dmchristiansen/ECE411_Mini_Synth/Design Notes/Audio amplifier stage block diagram.PNG

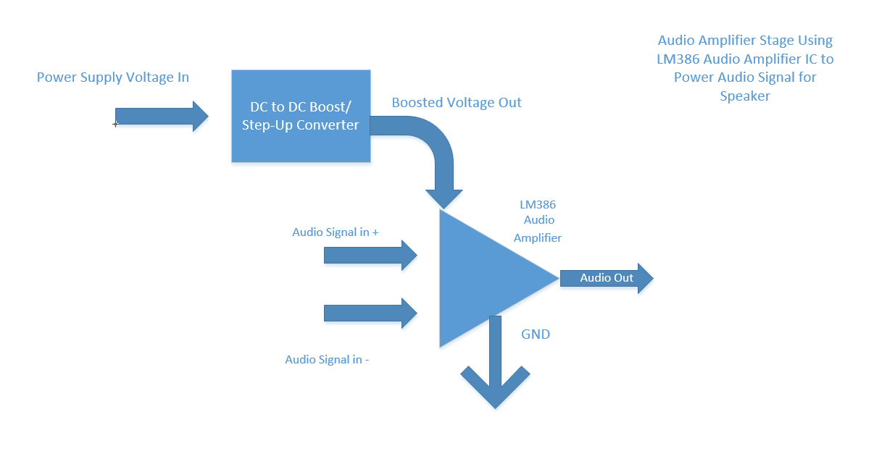
Design Notes/Audio amplifier stage block diagram.PNG
