dmchristiansen/ECE411_Mini_Synth/Design Notes/Charging Diagram.png

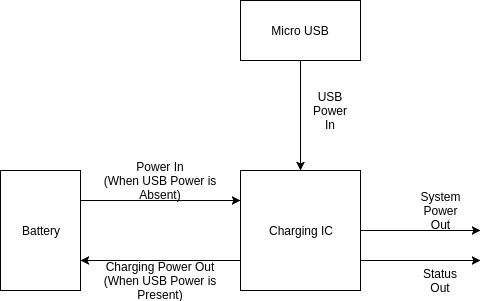
Design Notes/Charging Diagram.png
