dmchristiansen/ECE411_Mini_Synth/Design Notes/crystal_schematic.jpg

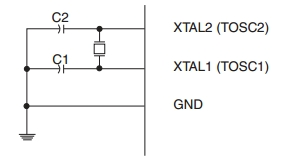
Design Notes/crystal_schematic.jpg
