dmchristiansen/ECE411_Mini_Synth/Design Notes/Top_level.png

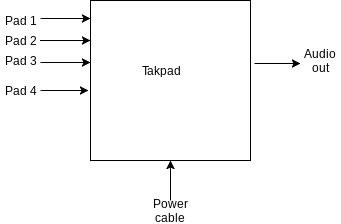
Design Notes/Top_level.png
