dmchristiansen/ECE411_Mini_Synth/Design Notes/Bill Of Materials.pdf

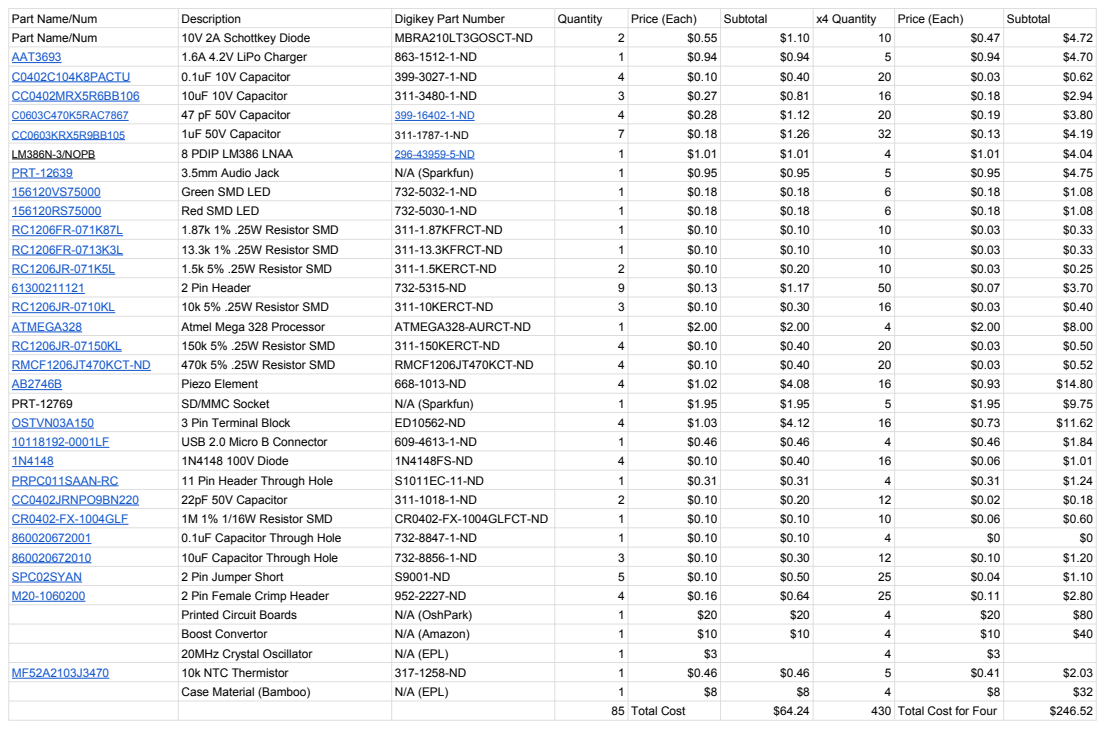
[picture p9: page 1]
Part Name/Num; Description; Digikey Part Number; Quantity; Price (Each); Subtotal; x4 Quantity; 10V 2A Schottkey Diode; MBRA210LT3GOSCT-ND; AAT3693; 1.6A 4.2V LiPo Charger; C0402C104K8PACTU; 0.1uF 10V Capacitor; CC0402MRX5R6BB106; 10uF 10V Capacitor; C0603C470K5RAC7867; 47 pF 50V Capacitor; CC0603KRX5R9BB105; 1uF 50V Capacitor; LM386N-3/NOPB; 8 PDIP LM386 LNAA; PRT-12639; 3.5mm Audio Jack; N/A (Sparkfun); Green SMD LED; Red SMD LED; 1.87k 1% .25W Resistor SMD; 311-1.87KFRCT-ND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
