dmchristiansen/ECE411_Mini_Synth/Board Design/takpad6.2.brd

## EAGLE design Board Design/takpad6.2.brd (2017-11-16)

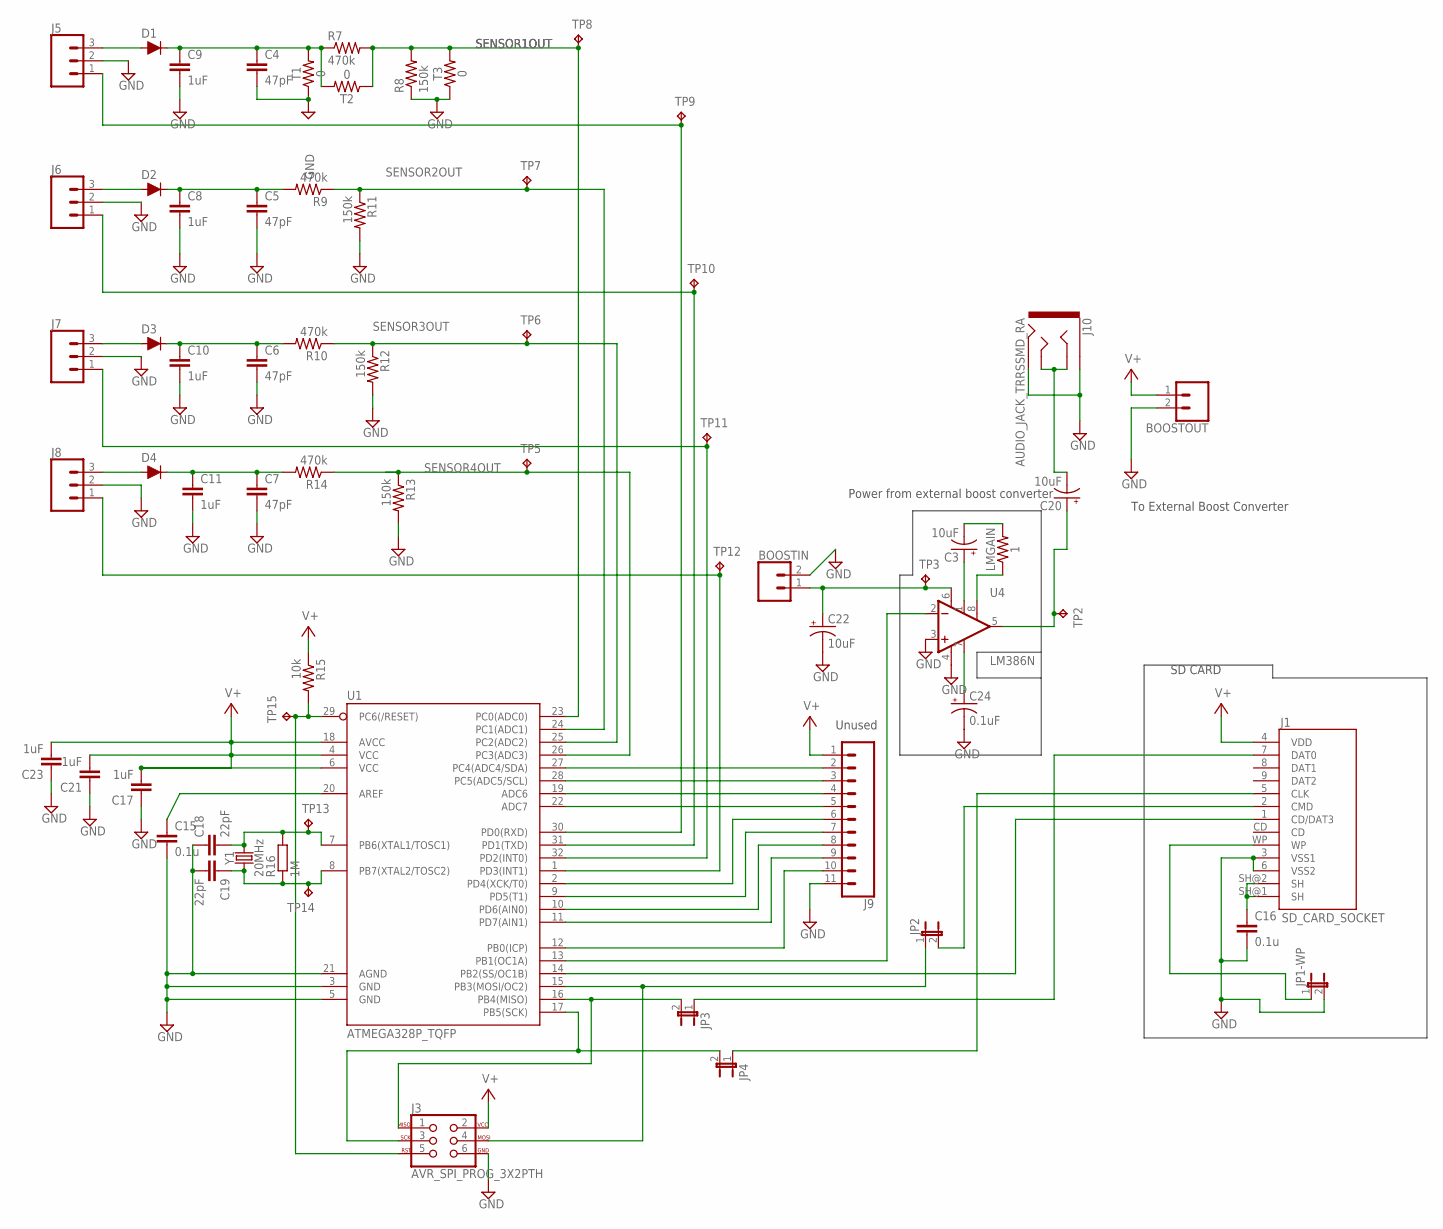
[picture p10: schematic takpad6.2.sch, sheet 1]

Parts:
BOOSTIN: CONN_02; 1X02
BOOSTOUT: CONN_02; 1X02
C3, C20, C22: 10uF; CPOL-RADIAL-2.5MM-5MM-KIT
C4, C5, C6, C7: 47pF; 0603
C8, C9, C10, C11, C17, C21, C23: 1uF; 0603
C15, C16: 0.1u; C0402
C18, C19: 22pF; C0402
C24: 0.1uF; CPOL-RADIAL-2.5MM-5MM-KIT
D1, D2, D3, D4: 200mA/100V/1V; DIODE-1N4148
J1: SD_CARD_SOCKET; SD
J3: AVR_SPI_PROG_3X2PTH; 2X3
J5, J6, J7, J8: CONN_03; 1X03
J9: CONN_11; 1X11
J10: AUDIO_JACK_TRRSSMD_RA; AUDIO_JACK_3.5MM_TRRS_SMD_RA
JP1-WP, JP2, JP3, JP4: JUMPER-2PTH; 1X02
LMGAIN: 1; 0603
R7, R9, R10, R14: 470k; M1206
R8, R11, R12, R13: 150k; M1206
R15: 10k; M1206
R16: 1M; R0402
T1, T2, T3: 0; AXIAL-0.3
TP2, TP3, TP5, TP6, TP7, TP8, TP9, TP10, TP11, TP12, TP13, TP14, TP15: TPB1,27; B1,27
U1: ATMEGA328P_TQFP; TQFP32-08
U4: LM386N; DIP08
Y1: 20MHz; HC49US

Connections:
ADC4: J9.2, U1.27 (PC4(ADC4/SDA))
ADC5: J9.3, U1.28 (PC5(ADC5/SCL))
ADC6: J9.4, U1.19 (ADC6)
ADC7: J9.5, U1.22 (ADC7)
AREF: C15.1, U1.20 (AREF)
AUDIOINPUT: U1.13 (PB1(OC1A)), U4.2 (-IN)
AUDIOOUT: C20.1 (+), TP2.TP, U4.5 (OUT)
BYPASS: C24.1 (+), U4.7 (BP)
CD/DAT3: J1.1 (CD/DAT3), U1.14 (PB2(SS/OC1B))
CLK: J1.5 (CLK), JP4.1
CMD: J1.2 (CMD), JP2.2
DAT0: J1.7 (DAT0), JP3.1
GND: BOOSTIN.2, BOOSTOUT.2, C4.2, C5.2, C6.2, C7.2, C8.2, C9.2, C10.2, C11.2, C15.2, C16.2, C17.1, C18.1, C19.2, C21.1, C22.2 (-), C23.1, C24.2 (-), J1.3 (VSS1), J1.6 (VSS2), J3.6, J5.2, J6.2, J7.2, J8.2, J9.11, J10.EARTH, J10.RING2, JP1-WP.2, R8.1, R11.2, R12.2, R13.2, T1.P$1 (1), T3.P$1 (1), U1.3 (GND), U1.5 (GND), U1.21 (AGND), U4.3 (+IN), U4.4 (V-); also elsewhere on the board
MISO: J3.1, JP3.2, U1.16 (PB4(MISO))
MOSI: J3.4, JP2.1, U1.15 (PB3(MOSI/OC2))
unnamed: C20.2 (-), J10.RING1, J10.TIP
unnamed: C3.1 (+), U4.1 (GAIN)
unnamed: C3.2 (-), LMGAIN.2
unnamed: LMGAIN.1, U4.8 (GAIN)
unnamed: C16.1, J1.SH@1 (SH), J1.SH@2 (SH)
PB6: C18.2, R16.2, TP13.TP, U1.7 (PB6(XTAL1/TOSC1)), Y1.2
PB7: C19.1, R16.1, TP14.TP, U1.8 (PB7(XTAL2/TOSC2)), Y1.1
PD4: J9.6, U1.2 (PD4(XCK/T0))
PD5: J9.7, U1.9 (PD5(T1))
PD6: J9.8, U1.10 (PD6(AIN0))
PD7: J9.9, U1.11 (PD7(AIN1))
PD8: J9.10, U1.12 (PB0(ICP))
RST: J3.5, R15.2, TP15.TP, U1.29 (PC6(/RESET))
SCK: J3.3, JP4.2, U1.17 (PB5(SCK))
SENS1LED: J5.1, TP9.TP, U1.30 (PD0(RXD))
SENS2LED: J6.1, TP10.TP, U1.31 (PD1(TXD))
SENS3LED: J7.1, TP11.TP, U1.32 (PD2(INT0))
SENS4LED: J8.1, TP12.TP, U1.1 (PD3(INT1))
SENSOR1: D1.A, J5.3
SENSOR1IN: C4.1, C9.1, D1.C, R7.1, T1.P$2 (2), T2.P$2 (2)
SENSOR1OUT: R7.2, R8.2, T2.P$1 (1), T3.P$2 (2), TP8.TP, U1.23 (PC0(ADC0))
SENSOR2: D2.A, J6.3
SENSOR2IN: C5.1, C8.1, D2.C, R9.2
SENSOR2OUT: R9.1, R11.1, TP7.TP, U1.24 (PC1(ADC1))
SENSOR3: D3.A, J7.3
SENSOR3IN: C6.1, C10.1, D3.C, R10.2
SENSOR3OUT: R10.1, R12.1, TP6.TP, U1.25 (PC2(ADC2))
SENSOR4: D4.A, J8.3
SENSOR4IN: C7.1, C11.1, D4.C, R14.2
SENSOR4OUT: R13.1, R14.1, TP5.TP, U1.26 (PC3(ADC3))
UPCONVERTERINPUT: BOOSTIN.1, C22.1 (+), TP3.TP, U4.6 (V+)
V+: BOOSTOUT.1, C17.2, C21.2, C23.2, J1.4 (VDD), J3.2, J9.1, R15.1, U1.4 (VCC), U1.6 (VCC), U1.18 (AVCC); also elsewhere on the board
WP: J1.WP, JP1-WP.1

Notes on the sheet:
SD CARD
To External Boost Converter
Power from external boost converter
Unused

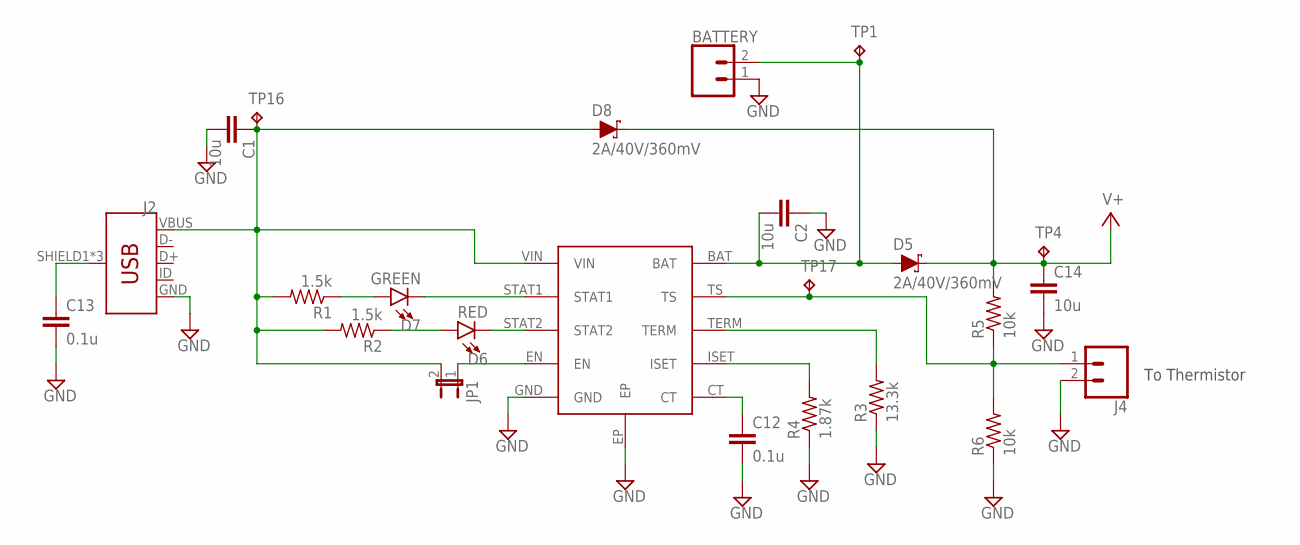
[picture p11: schematic takpad6.2.sch, sheet 2]

Parts:
BATTERY: CONN_02; 1X02
C1, C2, C14: 10u; C0402
C12, C13: 0.1u; C0402
D5, D8: 2A/40V/360mV; SMA-DIODE
D6: RED; LED-1206
D7: GREEN; LED-1206
J2: USB_MICRO-BREDUCED_PASTE; USB-B-MICRO-SMD_RED_PASTE
J4: CONN_02; 1X02
JP1: JUMPER-2PTH; 1X02
R1, R2: 1.5k; M1206
R3: 13.3k; M1206
R4: 1.87k; M1206
R5, R6: 10k; M1206
TP1, TP4, TP16, TP17: TPB1,27; B1,27
U$1: AAT3693; IDH-AA-T1

Connections:
BAT: BATTERY.2, C2.2, D5.A, TP1.TP, U$1.BAT
CT: C12.1, U$1.CT
EN: JP1.1, U$1.EN
GND: BATTERY.1, C1.2, C2.1, C12.2, C13.2, C14.2, J2.GND, J4.2, R3.1, R4.1, R6.1, U$1.EP, U$1.GND; also elsewhere on the board
ISET: R4.2, U$1.ISET
unnamed: C13.1, J2.SHIELD1 (SHIELD), J2.SHIELD2 (SHIELD), J2.SHIELD3 (SHIELD)
STAT1: D7.C, U$1.STAT1
STAT1LED: D7.A, R1.1
STAT2: D6.C, U$1.STAT2
STAT2LED: D6.A, R2.1
TEMPSENSE: J4.1, R5.1, R6.2, TP17.TP, U$1.TS
TERM: R3.2, U$1.TERM
V+: C14.1, D5.C, D8.C, R5.2, TP4.TP; also elsewhere on the board
VIN: C1.1, D8.A, J2.VBUS, JP1.2, R1.2, R2.2, TP16.TP, U$1.VIN

Notes on the sheet:
To Thermistor

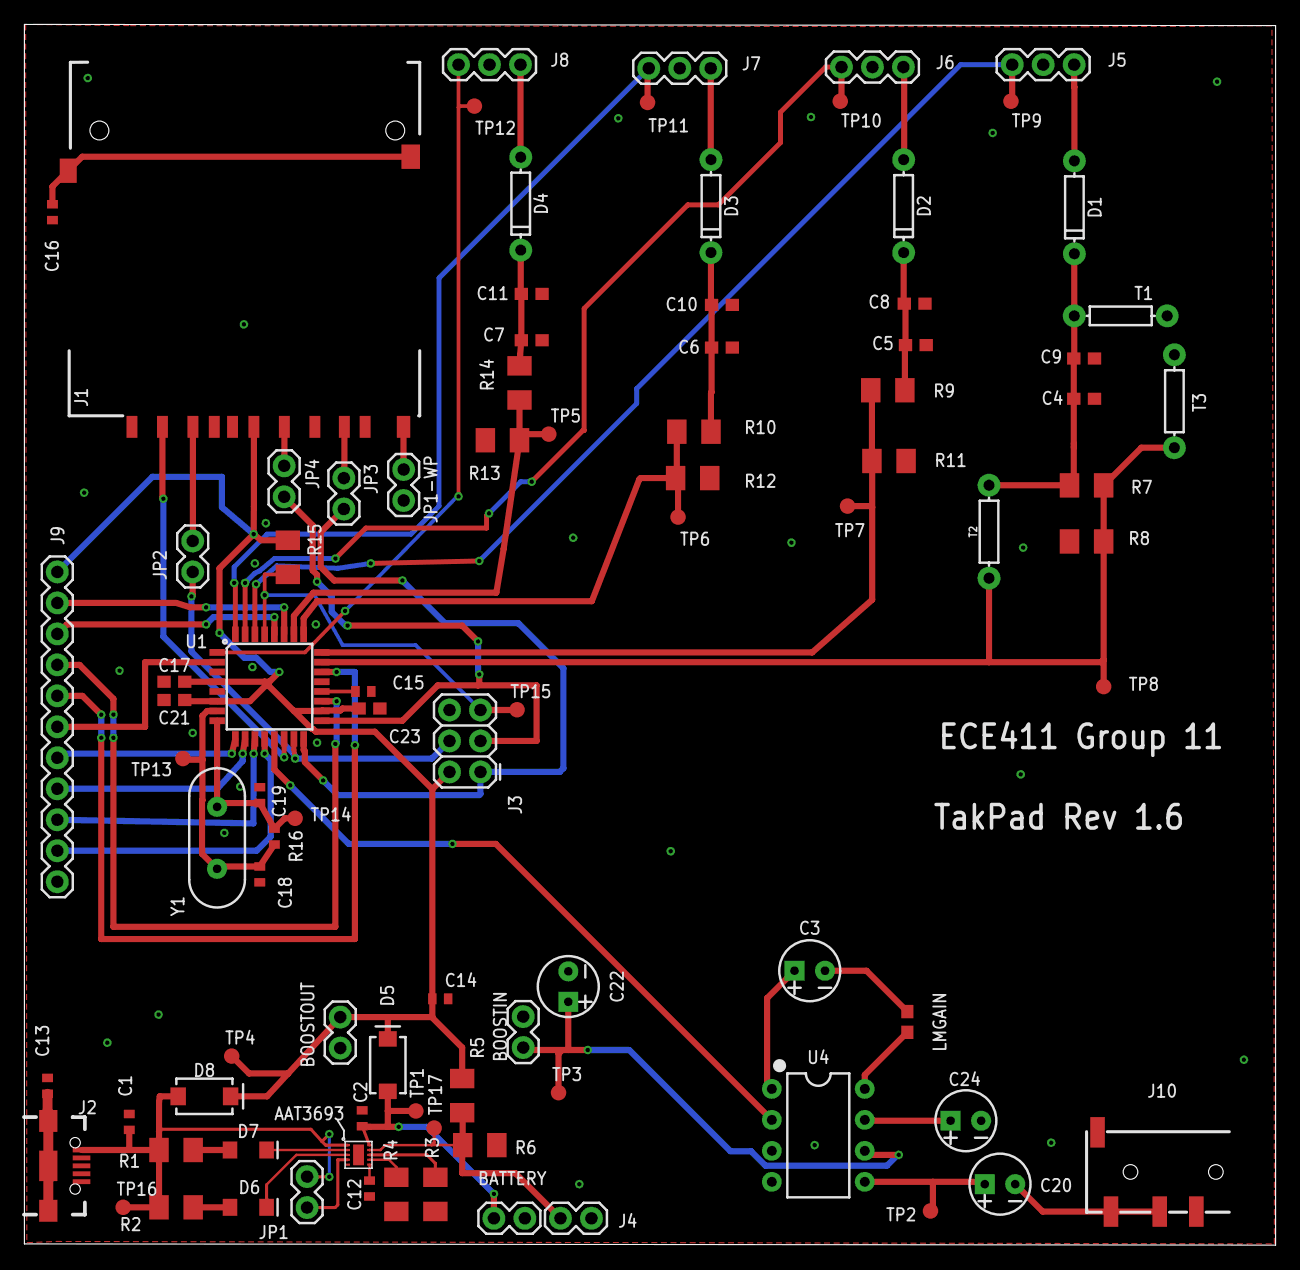
[picture p12: board takpad6.2.brd from above]

Board: 2 copper layers, 102.6 x 100.1 mm, 91 parts (0 on the bottom side), 60 nets.
