dmchristiansen/ECE411_Mini_Synth/Board Design/TakpadV3.brd

## EAGLE design Board Design/TakpadV3.brd (2017-11-09, an earlier design)

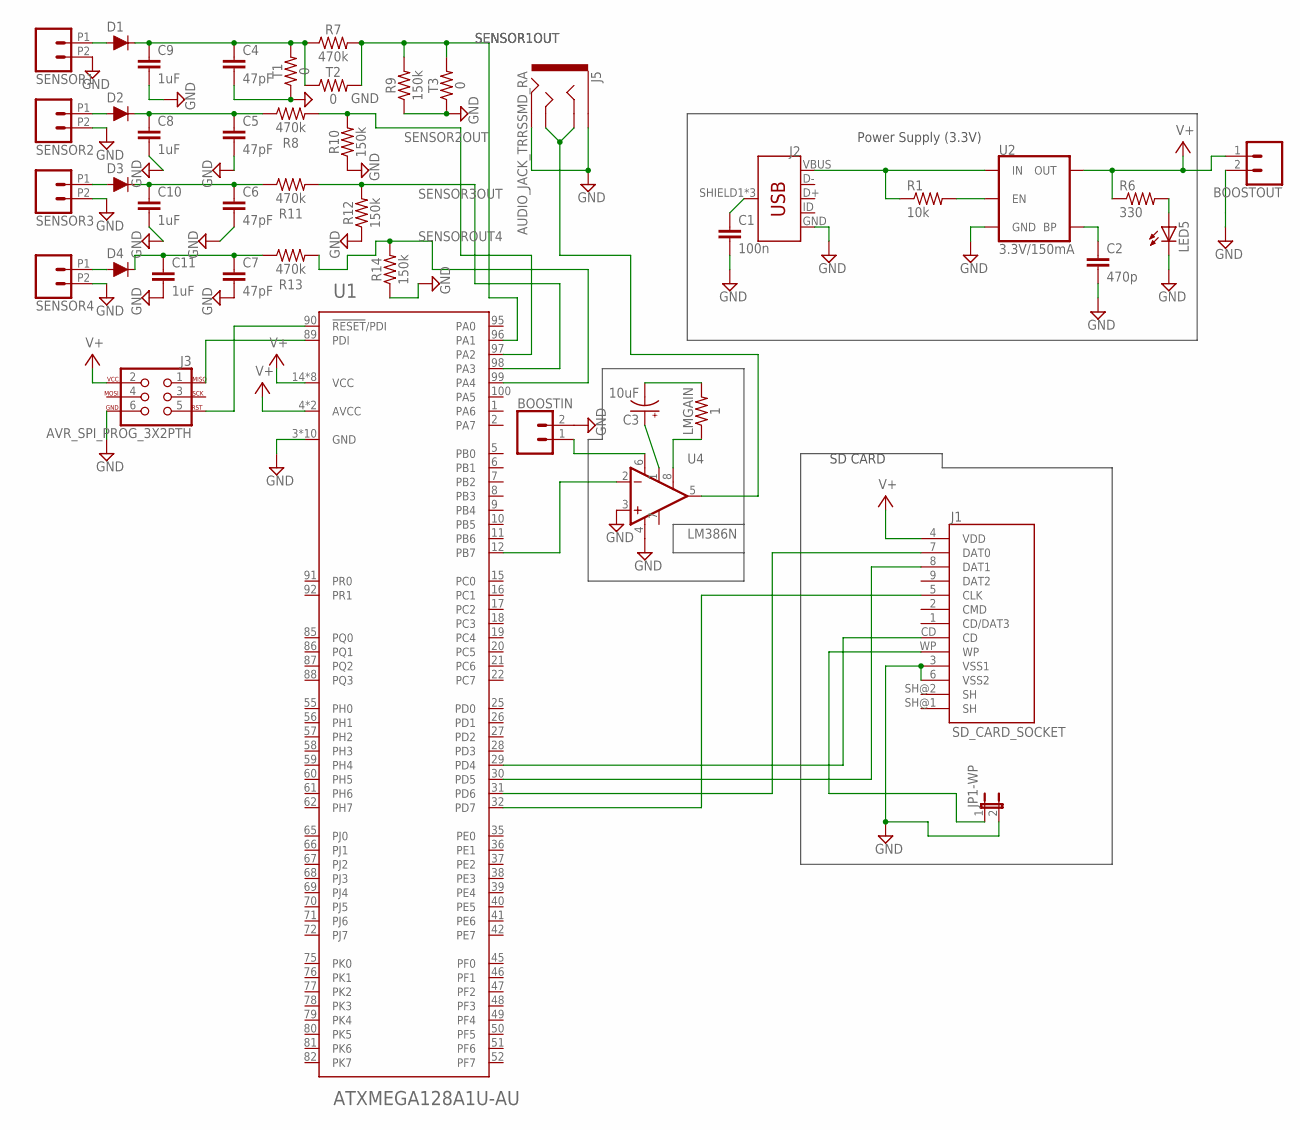
[picture p13: schematic TakpadV3.sch]

Parts:
BOOSTIN: CONN_02; 1X02
BOOSTOUT: CONN_02; 1X02
C1: 100n; C1206
C2: 470p; C1206
C3: 10uF; CPOL-RADIAL-2.5MM-5MM-KIT
C4, C5, C6, C7: 47pF; 0603
C8, C9, C10, C11: 1uF; 0603
D1, D2, D3, D4: 200mA/100V/1V; DIODE-1N4148
J1: SD_CARD_SOCKET; SD
J2: USB_MICRO-B_FEMALE-SMT; USB-B-MICRO-SMD
J3: AVR_SPI_PROG_3X2PTH; 2X3
J5: AUDIO_JACK_TRRSSMD_RA; AUDIO_JACK_3.5MM_TRRS_SMD_RA
JP1-WP: JUMPER-2PTH; 1X02
LED5: LED10MM
LMGAIN: 1; 0603
R1: 10k; M1206
R6: 330; 0204/7
R7, R8, R11, R13: 470k; AXIAL-0.3
R9, R10, R12, R14: 150k; AXIAL-0.3
SENSOR1, SENSOR2, SENSOR3, SENSOR4: CONN_022.54MM_SCREWTERM; 1X02_2.54_SCREWTERM
T1, T2, T3: 0; AXIAL-0.3
U1: ATXMEGA128A1U-AU; TQFP-100A-100
U2: 3.3V/150mA; SOT23-5
U4: LM386N; DIP08

Connections:
AUDIOINPUT: U1.12 (PB7), U4.2 (-IN)
AUDIOOUT: J5.RING1, J5.TIP, U4.5 (OUT)
BP: C2.1, U2.4 (BP)
CD: J1.CD, U1.29 (PD4)
CLK: J1.5 (CLK), U1.32 (PD7)
DAT0: J1.7 (DAT0), U1.31 (PD6)
DAT1: J1.8 (DAT1), U1.30 (PD5)
EN: R1.2, U2.3 (EN)
GND: BOOSTIN.2, BOOSTOUT.2, C1.2, C2.2, C4.2, C5.2, C6.2, C7.2, C8.2, C9.2, C10.2, C11.2, J1.3 (VSS1), J1.6 (VSS2), J2.GND, J3.6, J5.EARTH, J5.RING2, JP1-WP.2, LED5.K (C), R9.P$1 (1), R10.P$1 (1), R12.P$1 (1), R14.P$1 (1), SENSOR1.P2 (2), SENSOR2.P2 (2), SENSOR3.P2 (2), SENSOR4.P2 (2), T1.P$1 (1), T3.P$1 (1), U1.3 (GND), U1.13 (GND), U1.23 (GND), U1.33 (GND), U1.43 (GND), U1.53 (GND), U1.63 (GND), U1.73 (GND), U1.84 (GND), U1.93 (GND), U2.2 (GND), U4.3 (+IN), U4.4 (V-)
LED: LED5.A, R6.2
MISO: J3.1, U1.89 (PDI)
unnamed: C3.1 (+), U4.1 (GAIN)
unnamed: C3.2 (-), LMGAIN.2
unnamed: LMGAIN.1, U4.8 (GAIN)
RST: J3.5, U1.90 (!RESET!/PDI)
SENSOR1: D1.A, SENSOR1.P1 (1)
SENSOR1IN: C4.1, C9.1, D1.C, R7.P$1 (1), T1.P$2 (2), T2.P$1 (1)
SENSOR1OUT: R7.P$2 (2), R9.P$2 (2), T2.P$2 (2), T3.P$2 (2), U1.96 (PA1)
SENSOR2: D2.A, SENSOR2.P1 (1)
SENSOR2IN: C5.1, C8.1, D2.C, R8.P$1 (1)
SENSOR2OUT: R8.P$2 (2), R10.P$2 (2), U1.97 (PA2)
SENSOR3: D3.A, SENSOR3.P1 (1)
SENSOR3IN: C6.1, C10.1, D3.C, R11.P$1 (1)
SENSOR3OUT: R11.P$2 (2), R12.P$2 (2), U1.98 (PA3)
SENSOR4: D4.A, SENSOR4.P1 (1)
SENSOR4IN: C7.1, C11.1, D4.C, R13.P$1 (1)
SENSOROUT4: R13.P$2 (2), R14.P$2 (2), U1.99 (PA4)
SHIELD: C1.1, J2.SHIELD1 (SHIELD), J2.SHIELD2 (SHIELD), J2.SHIELD3 (SHIELD)
UPCONVERTERINPUT: BOOSTIN.1, U4.6 (V+)
V+: BOOSTOUT.1, J1.4 (VDD), J3.2, R6.1, U1.4 (AVCC), U1.14 (VCC), U1.24 (VCC), U1.34 (VCC), U1.44 (VCC), U1.54 (VCC), U1.64 (VCC), U1.74 (VCC), U1.83 (VCC), U1.94 (AVCC), U2.5 (OUT)
VIN: J2.VBUS, R1.1, U2.1 (IN)
WP: J1.WP, JP1-WP.1

Notes on the sheet:
Power Supply (3.3V)
SD CARD

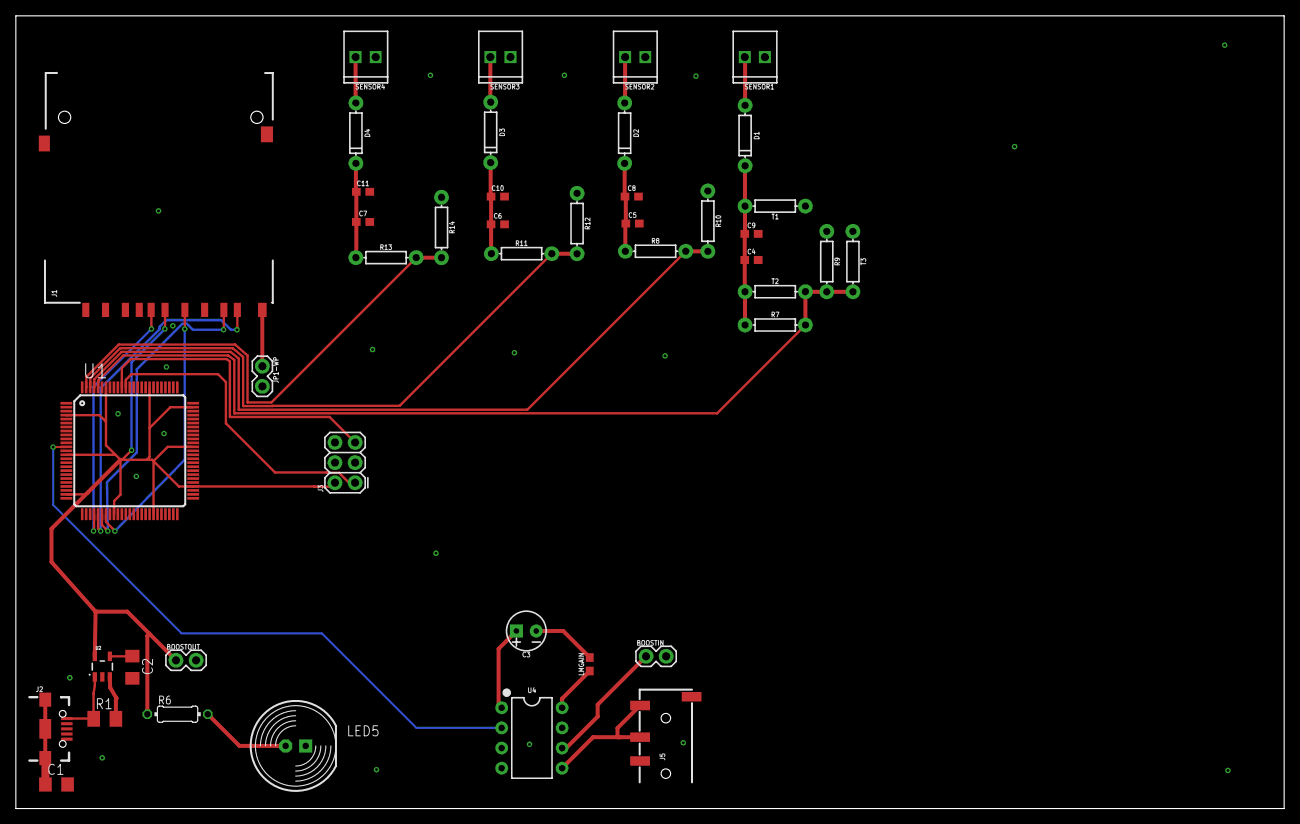
[picture p14: board TakpadV3.brd from above]

Board: 2 copper layers, 160.0 x 100.0 mm, 44 parts (0 on the bottom side), 32 nets.
