dmchristiansen/ECE411_Mini_Synth/code/Takpad_328P/Takpad_328P/wavetable.h

// wavetable.h

const int8_t clap[] PROGMEM = {
0, 28, 44, 61, 79, 104, 126, 117, 105, 104, 90, 88, 90, 51, 2, -36,
-85, -107, -93, -88, -91, -81, -62, -22, 24, 46, 52, 65, 73, 68, 67, 68,
59, 40, 9, -28, -57, -76, -91, -94, -91, -84, -58, -23, 9, 37, 50, 49,
53, 65, 72, 77, 82, 86, 89, 83, 66, 60, 62, 47, 29, 25, 13, -19,
-41, -41, -52, -78, -84, -72, -70, -65, -49, -53, -68, -61,
-48, -57, -68, -51, -29, -37, -62, -72, -62, -45, -46, -70, -81, -68, -56, -45,
-32, -14, 13, 32, 38, 52, 53, 34, 37, 56, 62, 73, 84, 75, 70, 65,
41, 18, 0, -35, -57, -50, -47, -51, -32, 12, 52, 59, 48, 53, 61, 53,
50, 62, 83, 95, 87, 63, 35, 14, 20, 30, 14, -14, -33, -36, -40, -60,
-71, -66, -71, -84, -83, -59, -14, 16, 39, 80, 89, 58, 51, 47, 12, -5,
-9, -35, -54, -43, -20, 0, 19, 37, 38, 25, 14, -5, -34, -35, -13, -4,
-13, -24, -32, -37, -41, -41, -30, -14, -20, -44, -41, -9, 19, 41, 60, 76,
85, 82, 85, 88, 63, 39, 41, 28, 3, 4, 6, 2, 15, 23, 15, 6,
-3, -14, -14, -13, -18, -14, -6, -14, -25, -16, -7, -14, -20, -19, -25, -43,
-64, -74, -71, -63, -59, -56, -39, -5, 19, 33, 43, 47, 52, 46, 19, -2,
-11, -20, -17, 3, 25, 32, 5, -35, -46, -41, -49, -61, -75, -89, -90, -78,
-61, -33, -3, 21, 49, 68, 66, 63, 67, 63, 54, 43, 10, -25, -44, -62,
-78, -76, -68, -59, -42, -26, -17, -15, -19, -24, -16, -2, 10, 26, 42, 51,
54, 56, 59, 65, 74, 82, 83, 74, 73, 78, 73, 60, 47, 27, 11, 0,
-25, -49, -51, -54, -71, -89, -94, -93, -92, -82, -54, -21, 3, 18, 33, 41,
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
	12,12,12,11,11,11,11,11,
	11,10,10,10,10,10,10,9,
	9,9,9,9,9,9,8,8,
	8,8,8,8,8,8,7,7,
	7,7,7,7,7,7,7,6,
	6,6,6,6,6,6,6,6,
	6,6,5,5,5,5,5,5,
	5,5,5,5,5,5,5,4,
	4,4,4,4,4,4,4,4,
	4,4,4,4,4,4,4,3,
	3,3,3,3,3,3,3,3,
	3,3,3,3,3,3,3,3,
	3,3,3,3,3,2,2,2,
	2,2,2,2,2,2,2,2,
	2,2,2,2,2,2,2,0
};
