dmchristiansen/ECE411_Mini_Synth/(commit log)

2017-11-02 Delete Sound Board V2.zip
    removing file for rename
2017-11-02 Add files via upload
    renamed file for schematic
2017-11-08 Add files via upload
    Block Diagram of Charging Circuit
2017-11-08 Add files via upload
    Audio Amplifier Stage Block Diagram
2017-11-09 Add files via upload
    -Sensor Inputs Added
    -Audio Output Added
    -Initial Board Layout Created
    [TakpadV3.brd, TakpadV3.sch]
2017-11-10 Add files via upload
    Initial Charging Circuit Design
    [Charging Circuit.sch]
2017-11-14 Add files via upload
    Updated processor, added charging schematic
    [TakpadV4.brd, TakpadV4.sch]
2017-11-15 Add files via upload
    Board layout completed
    Added pinout for unused pins
    Added LEDout to sensor connectors
    [TakpadV6.brd, TakpadV6.sch]
2017-11-15 Add files via upload
    Minor Changes
    [TakpadV6.1.brd, TakpadV6.1.sch]
2017-11-15 Add files via upload
    added test points to voltage points of interest. Caps to input voltages, cap on output of lm386, smd resistors on inputs
    [TakpadV6.1.sch]
2017-11-16 Add files via upload
    TO DO LIST:
    MAJOR - 0.1uF caps by voltage pins - done (some of these are 1uF, is this the right value?)
    Label pinouts, (not really sure what I am supposed to label)
    change a few font sizes
    some routing
    some TP placement
    [takpad6.2.brd, takpad6.2.sch]
2017-11-16 Add files via upload
    nearly done hope this works, cross fingers
    [takpad6.2.brd, takpad6.2.sch]
2017-11-17 Added wavetable and untested interrupt routine
2017-11-18 It produces terrible noises now
    [main.c, wavetable.h]
2017-11-21 Fixed note_count behaivor, tidied code
    [main.c, synth.h]
2017-12-07 fixed multi-note triggering & note overlap
    [main.c, wavetable.h]
2017-12-07 tidying repo
    [Charging Circuit.sch, TakpadV3.brd, TakpadV3.sch, TakpadV4.brd, TakpadV4.sch, TakpadV5.brd, TakpadV5.sch, TakpadV6.1.brd]
